Arthrimus/Wii-HDMI/(list of files, drawings)

Other design files:
PCB/Flex QSB/Wii HDMI Board flex 01-30.dip
PCB/Flex QSB/Wii HDMI Board flex.dip
PCB/Main PCB Set/Wii HDMI Board 1.1 Set.dip
