Arthrimus/Wii-HDMI/(threads)

Thread 2 (2020-07-25):

Mousebites missing between IR and HDMI boards?

loopj, 2020-07-25:
Hey @Arthrimus thanks for open sourcing this, this is my favorite board design for GCVideo on Wii!

I've noticed that the Gerbers (on `master` dont show drill holes for the PCB "mouse bites" allowing you to break apart the IR board from the HDMI board. Did you remove the mouse bites or are they accidentally missing from this version?

Thanks again

drandreas, 2020-12-02:
I've re-generated the Gerber files from the `.dip`. That one contains the mouse bites. I've ordered 3 from OSH Park. Looking forward to soldering during the holidays.

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

webhdx, 2021-03-31:
Hey @drandreas Can you open a pull request with updated gerbers or send them to me via e-mail (webhdx@gmail.com)? I can't generate them myself with freeware version of DipTrace. Thanks in advance.

drandreas, 2021-03-31:
https://oshpark.com/shared_projects/WkDGBf2d

drandreas, 2021-03-31:
I’ve also uploaded the flex:
https://oshpark.com/shared_projects/A5FDOKa1

But that one is not tested since I had spare once from Wii-Duals

Thread 3 (2020-12-02):

HDMI modded Wii Mini

webhdx, 2020-12-02:
I thought I would share this. Probably I'm the first person ever to add HDMI to the Wii Mini (I did a lot of research). Wii-HDMI boards fit perfectly to RVO-CPU-01 boards if you remove one filtering cap. HDMI board also need to be dremeled a bit to accommodate 3 caps near the USB port. As you can see it can be soldered using only one row of pins.

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

Thanks for this project. I modded a lot of Wiis using this. It's great that we can make Wii more compatible in the future when Component is finally removed from the TVs.

Arthrimus, 2020-12-02:
Wow, that's awesome. Can you get progressive scan working or does it only
do interlaced?

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

webhdx, 2020-12-02:
It can be done but you need to do Bluebomb hack first. Then you can install original Wii's System Menu which has 480p setting. Also I installed WiFi card which also required new System Menu in order to work.

LakituLakitu, 2025-02-01:
I google wii mini HDMI mod every few months and have done for a long time. You as you know are the only one. I added a gamecube controller port to mine and did Bluebomb years a go and have adored the wii mini ever since. I would love for you to do a detailed wiring map so i could wire this myself. My soldering skills are great if i have some instruction. Long live the wii mini. It's a beautiful thing.

Thread 4 (2021-01-21):

PCB Testing

drandreas, 2021-01-21:
I've noticed that there is no oscillator or other clock source on the PCB. Does the FPGA depend on the 54 MHz-Clock on Pin C or will it run on an internal clock.

I would like to test the Firmware/PCB/HDMI Output before fitting the PCB into the Wii.

drandreas, 2021-01-25:
I've made some progress over the weekend. The FPGA requires an external clock source - a Raspberry Pi (see GPCLK, Pin4) seams sufficient.  Moreover, GCVideo does not output anything as long as it hasn't synced to the Wii's output. I'm currently trying to write test image generator. I will report back when I come up with something useful.

For now, just a warning to all other beginners like me: **TMDS signal pairs are swapped** (this makes for an easier layout without vias).

drandreas, 2021-02-28:
I gave up and just hoped for the best, it worked.

Closed 2021-02-28.

Thread 5 (2021-02-28):

BOM Sugestions

drandreas, 2021-02-28:
I've successfully built 3 PCBs. The IR-Diode is EOL I've ordered all other components from DigiKey.

I suggest the following 2 positions:

The FFC cable is not part of the Excel sheet. Therefore I had to guess the length.
I've ended up with CABLE FFC 20POS 0.50MM 3.94" (100mm), order no 732-5164-ND (687620100002).

I had a hard time hand soldiering the suggested HDMI receptacle. I've then switched to the following alternative:
order no 732-2739-1-ND (685119136923) since it has almost not plastic at the back side there is nothing you could accidentally melt with the soldering iron. Moreover, the exposed part of the pins is significantly longer and hence easier to heat. The alternative part has the same footprint as the original. However, the legs are to long and have to be shortened before soldering to get a flush pcb bottom. They are soft so a side cutter can do the job.

SMazza1, 2021-08-24:
I tried uploading the BOM to Digi-Key and found 5 issues.  Digi-Key was unable to identify the 4 resistors beginning with "0603WAF".  And the IC "TPS74012DGKR" is only available in bulk quantities.

The resistors seem like they should be easy enough to substitute, but Digi-Key's system didn't identify acceptable substitutes for some reason.  I haven't yet tried selecting substitutes from a catalog.

While I haven't studied the circuit very hard, the "TPS74012DGKR" IC seems like it might be a little more sensitive to product substitutions.  Did you find any issue with the substitution for that one?

drandreas, 2021-08-24:
I’ve ordered TPS74012DGKT back in December. I assume the T variant is the successor of the R you mentioned. As far as I know it’s only a 1.8V regular, so not that big of a deal. The boards I assembled have not shown any issues so far.

SMazza1, 2021-08-24:
Thanks, that's helpful.  They have that chip in stock at $4.66 each, no minimum quantity.

For the resistors, it looks like TE products CRGCQ0603F180R, CRGCQ0603F330R, CRGCQ0603F4K7, and CRGCQ0603F10K might work, and are shown in stock at Digi-Key.

drandreas, 2021-08-25:
Sorry, I can’t give any feedback on the resistors. I have an assortment in my shop and usually use what I’ve at hand.

If you are ordering for this specific build - you will meed a .1u 50v cap for the flex. That one is not listed in the BOM as far as I know.

Source: https://forums.black-dog.tech/index.php?threads/wiidual-removed-c43-capacitor-under-flex-cable.37/

jpaglier, 2022-01-19:
I had trouble finding the flash IC - successfully used a MX25V4006EM1I-13G in its place.

Thread 6 (2021-07-09):

Analog video

Bakuku, 2021-07-09:
Is there a way to modify this project to also include the Analog video options that Wii Dual offers?

drandreas, 2021-07-09:
(This is not the answer you were looking for.) Installing Wii-HDMI does not disable the Analog Output. Moreover, I have a Wii with Wii Dual and one with Wii-HDMI and I see no difference between the original analog output and Wii Duals analog out.

Bakuku, 2021-07-09:
But not all of them or al I wrong?

RGBS/RGBHV/RGsB/YPbPr

drandreas, 2021-07-09:
Good Point

Bakuku, 2021-07-09:
What extra components are needed to make that work? It would be great to have a full alternative to WiiDual and that is opensource!

drandreas, 2021-07-09:
If you look at the constraints file of gc-video for the wii-dual: https://github.com/ikorb/gcvideo/blob/main/HDL/gcvideo_dvi/src/constraints-dualwii.ucf you will find the pin-out of the FPGA to the DACs. However, the entire analog pipeline is missing on wii-hdmi. So you need to take those ~24 Signals and build the rest from scratch.

Bakuku, 2021-07-09:
There is some overlap for around ~4-5 pins.
At first glance

Bakuku, 2021-07-09:
P77 = Net DVI_CLOCK[1] (Same on both)
P78 = Net DVI_CLOCK[1] (Same on both)
P88 = NET "DVI_Red[0]"   LOC = P88; / NET "DVI_Green[0]" LOC = P88;
P89= NET "DVI_Red[1]"   LOC = P89; / NET "DVI_Green[1]" LOC = P89
P83 = NET "DVI_Blue[0]"  LOC = P83; (Same on both)
P84 = NET "DVI_Blue[1]"  LOC = P83; (Same on both)
P73 = NET "DAC_Green[0]" LOC = P73 | IOSTANDARD = LVCMOS33; / NET "PadData"      LOC = P73;
P72 = NET "DAC_Green[1]" LOC = P72 | IOSTANDARD = LVCMOS33; / NET "SPDIF_Out"    LOC = P72;
P71 = NET "DAC_Green[2]" LOC = P71 | IOSTANDARD = LVCMOS33; / NET "IRReceiver"   LOC = P71;
P43 = NET "DAC_Green[6]" LOC = P43 | IOSTANDARD = LVCMOS33; / NET "VClockN"      LOC = P43;
P41 = NET "DAC_Green[7]" LOC = P41 | IOSTANDARD = LVCMOS33; / NET "I2S_BClock"   LOC = P41;
P13 = NET "DAC_Blue[7]"  LOC = P13 | IOSTANDARD = LVCMOS33; / NET "VData[5]"     LOC = P13;
P12 = NET "DAC_Clock"    LOC = P12 | IOSTANDARD = LVCMOS33; / NET "VData[4]"     LOC = P12;
P40 = NET "DAC_SyncN"    LOC = P40 | IOSTANDARD = LVCMOS33; / NET "I2S_Data"     LOC = P40;
P3 = NET "CSel"         LOC = P3; / NET "CableDetect"  LOC = P3;
P10 = NET "VData0Old"    LOC = P10 | OFFSET = IN 5 ns VALID 12 ns BEFORE "VClockN" LOW | IOSTANDARD = LVCMOS18 | PULLDOWN = TRUE; / NET "VData[3]"     LOC = P10;
P9 = NET "VData[1]"     LOC = P9; / NET "VData[2]"     LOC = P9;
P7 = NET "VData[2]"     LOC = P7; / NET "VData[1]"     LOC = P7;
P6 = NET "VData[3]"     LOC = P6; / NET "VData[0]"     LOC = P6;
P5 = NET "VData[4]"     LOC = P5; / NET "CSel"         LOC = P5;
P39 = NET "IRReceiver"  LOC = P39; / NET "I2S_LRClock"  LOC = P39;
P94 = NET "I2S_Data"    LOC = P94; / NET "DVI_Red[1]"   LOC = P94;
P93 = NET "I2S_BClock"  LOC = P93; / NET "DVI_Red[0]"   LOC = P93;
P70 = NET "SPDIF_Out"   LOC = P70; / NET "IRButton"     LOC = P70;

Is this what you meant?
I've crosschecked all the pins from the 2 links and these are the ones that overlap.

drandreas, 2021-07-09:
Yes, that's what I meant. Sigh, that's a lot of changes between the 2 layouts...

I'm not sure how familiar you are with FPGAs - I'm sorry if I state obvious stuff blow.

Challenge 1:
In theory almost any FPGA pin can be used for any signal (main exception are clocks, differential pairs and so on). However, all Logical Units (LUTs) are placed within the FPGA by the "compiler". If an input or output pin is far away from the LUT the path length can introduce signal delays and this in turn will reduce the max possible clock rate the FPGA can be run at. Therefore, keeping similar pins next to each other is key. e.g. DVI-Group, VDATA-Group, RGB-Groups (Obviously the "compiler" does optimise the placement to counter this issue but at some point the code will simply not fit into the FPGA and meet the timing requirements).

Challenge 2:
The FPGA usually groups 8-Pins into one Port and some things are defined per Port and not per Pin e.g. the logical voltages (1.8V / 3.3V).

If you are lucky you might be able to just assign the ~27 DAC signals to free pins in constraints-shuriken-v3.ucf and every thing will work. However, based on the challenged listed above I doubt if this is possible. Perhaps a full re-layout is necessary...

I've quickly compared the 2 boards side by side. The layout is defiantly different:
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
So your long list is plausible...

Thread 7 (2021-07-28):

Possible to re-arrance or split gerber for cheaper OSHPark production?

Hojo-Norem, 2021-07-28:
Going by https://docs.oshpark.com/submitting-orders/board-outline/ , OSHPark price PCBs by dimensions rather than surface area.

The design at https://oshpark.com/shared_projects/WkDGBf2d has a lot of open space and wastes a significant amount of money in it's production.

Going by the file extension 'Wii HDMI Board 0.4 Set.dip', I'm guessing you use Diptrace.

I'll give it a go myself if the trial version will let me.

drandreas, 2021-07-29:
Are you considering to move the PCB segment with the HDMI port on it or also additional changes?

Hojo-Norem, 2021-07-29:
Just move the HDMI section, unless you had some ideas.  Anyway, I got Diptrace installed and when I loaded 'Wii HDMI Board 0.4 Set.dip' I got the following dialogue:
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
This is my first time using Diptrace (I dabble a little with Eagle) so I just answered yes.
After a bit of messing around I managed to make this, using OSHPark's cutout guidelines:
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
[Wii HDMI Board 0.4 Set rearranged.zip](https://github.com/Arthrimus/Wii-HDMI/files/6903720/Wii.HDMI.Board.0.4.Set.rearranged.zip)

I generated the gerbers and uploaded them to OSHPark, where the quoted price is $23.10, vs $34.60 for the original.

Also, just to see what the difference was, I cut the PCB into it's three sections and uploaded the.  The total quoted price was $21.50.  I took the re-arranged PCB and removed the IR section and the total cost for the combined FPGA+HDMI sections and perseverate IR section comes to $19.65.

drandreas, 2021-07-30:
As you may have noticed, I'm not the original author. I just had some PCBs produced and successfully installed. If you would have separated the IR-Part I would have argued against it. On my first install I separated the 2 parts and realized then, that the install would have been significantly easier if I had kept them connected. The entire PCB with the HDMI part removed fits perfectly into the Wii.

I recall getting the same error message, but I can't remember how I answered the Question - sorry. I suggest you double check the gerbers. As long Dip does not add connections between traces that were not connected in the original you will be fine.

One side note my first batch produced was 1.6mm thick the Metal - ESD Cover of the Wii did not fit into the hole. I did the second PCB batch with 0.8mm thickness that one warped a little and the castellations ware partly damaged but recoverable. On the plus side I was able to fit the ESD Cover.

Thread 8 (2021-08-17):

Losing Composite Video when installing Wii-HDMI

Orcut, 2021-08-17:
When I install Wii-HDMI 0.4, I am losing composite video.  I know in the main description it says the Wii-HDMI is similar to Wii Dual, but that it only does HDMI.  So I was thinking that it just doesn't support the component features that the Wii Dual has.  Does anyone know if losing composite is a normal thing that happens?  If so, is there a way to get it working again?

drandreas, 2021-08-18:
I don't have any devices with analog input at hand. However if you set "Allow 480p mode" to off than composite should work like no Wii-HDMI was installed:
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

In all cases component should work like before the install.

Orcut, 2021-08-18:
Thank you for your input.  I just tried turning off "Allow 480p mode" and it did not work unfortunately.  If component should work like before the install as you said, then shouldn't composite work as well?

drandreas, 2021-08-18:
Strange, very Strange.

I don't have any analog input devices anymore. However I've tried to send the signal trough a Wii2Hdmi and use the WiiHDMI simultaneously and it works like a charm:

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

drandreas, 2021-08-29:
I've checked the v0.4 PCB. Pin 8 is tied to 3.3V (Pin 10). The Wii will therefore always assume that the console is connected to a TV using a component cable. I’m sorry for suggesting `Allow 480p mode`. I now know, that it has not effect when used on a v0.4 PCB of this repo. You can try to break the trace with an exacto knife to enable composite:

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

Thread 9 (2021-09-03):

Clarification Regarding v0.3 and v0.4

ianmarmour, 2021-09-03:
I'm not sure if anybody has context on this but I'm going to start attempting to build one of these soon and I noticed in this post,

https://github.com/Arthrimus/Wii-HDMI/issues/2

That there is a v0.4 board that was posted by drandreas however on Arthrimus's OshPark there's only a v0.3 board which one should I order and are there any differences between the two? I know Arthrimus is on a break right now but maybe someone else will know.

drandreas, 2021-09-03:
You should ask @Hojo-Norem if he had success with his re-aranged board presented in #7. I liked that Idea.

Hojo-Norem, 2021-09-03:
The PCBs arrived about week ago, but I haven't had chance to get the parts ordered yet.  They looked like they came out okay, and the HDMI section separated from the FPGA section without issue.  That being said, I misjudged the scale of everything, meaning that I had to take care when snapping the two PCBs apart as there is a trace running rather close to the snap line on the FPGA pcb.

Thread 11 (2023-05-31):

Several questions around the project

mattie47, 2023-05-31:
I've been reading through this project, and trying to narrow down how easy it would be to get manufactured, flash it, and finally install.

I see there's a few useful resources around such as:
- https://www.youtube.com/watch?v=8VhgLiL9o7c
- https://www.youtube.com/watch?v=odxJZlh90ks

**Questions:**
1. Is there a schematic for this anywhere?

I see the Diptrace dip file (and have downloaded and tried out diptrace as a result) but I see it's just the board.

2. I understand the repo's gerber files are actually out of date? i.e. 0.3 (without mouse-bites), and not 0.4

I see @drandreas has uploaded this variant of gerber to oshpark here: https://oshpark.com/shared_projects/WkDGBf2d

Any reason no one in the issues section here hasn't submitted a PR to the project with newer gerbers? It's better practise than going off-site.

3. Has anyone tried getting the boards with smt assembly?

Given there's not a schematic file to go along with the board file, it's not exactly easy to generate a pick and place file.

I was planning on trying to get a couple of these manufactured with smt assembly at jlcpcb.

4. Has anyone got any installation pics of this project?

Whilst there are some install photos on https://arthrimus.com/wii-hdmi-mod/, ~I've been trying to understand the usage of the flex cable i.e. https://github.com/Arthrimus/Wii-HDMI/tree/master/PCB/Flex%20QSB~

~Perhaps I missed it in some of the videos, and other comments/posts around, but I haven't come across an install with pics that's actually using it.~

~The main post of this project here https://arthrimus.com/wii-hdmi-mod/ states _"this mod is HDMI only, and does not have a custom flex cable designed for connecting it to the AVE-RVL chip"_. Am I mis-interpreting, or is this statement no longer true?~

Screenshot below from https://youtu.be/odxJZlh90ks?t=1068 showing the flex install:

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

-------

In terms of flashing the board, I see again @drandreas has written up some brief useful instructions [here](https://github.com/ikorb/gcvideo/issues/65#issuecomment-835420544) (thanks):

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

In other news, it looks like there's another variant/board out for 2023 although sadly doesn't look opensource - AVE-HDMI Kit https://www.youtube.com/watch?v=v44PfH3R4iA / https://electron-shepherd.com/products/ave-hdmi-kit

As for another project, I'm not sure whether https://github.com/wmi-0/wiihdmi also was production worthy...

Thanks,

Matt

drandreas, 2023-06-21:
I haven't found any schema myself. So I took the gamble with the PCBs you found on oshpark. I haven't had any issues with my installs so far. Yes, creating a pull request would have been nice. But since most of my discussions i.e. #5 went nowhere I didn't bother investing time into it. If you are interested in the pinout please see the FPGA definition file: https://github.com/ikorb/gcvideo/blob/main/HDL/gcvideo_dvi/src/constraints-shuriken-v3.ucf

I haven’t tried any other PCBs so I can’t comment on if they are better or worse.

Thread 12 (2023-12-26):

Alternative Flex QSP

mattie47, 2023-12-26:
Hi all,

Just curious if anyone sees issues as-is with modifying the flex cable based on below requirements?

Basically I've decided to build one of these and found the flex cable holes are too small for jlcpcb manufacturing:

> As shown below, for those 0.25mm holes as the board edge.
>
>Could you please kindly enlarge them to minimum size 0.3mm and keep minimum space between hole edge to hole edge to be at least 0.3mm?

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

In the off chance that someone has already run into the same issue, and has modified the flex cable already, that would also be useful!

Thanks

Arthrimus, 2023-12-27:
Interesting, JLCPCB recently made a batch of these for me and they also had an issue with the hole spacing, however they were able to shrink the holes for the castellations down to .015mm which solved the spacing issue and the flex cables turned out fine. I would ask them if they can do that for your order. To increase the hole size and the hole spacing would be impossible because it would no longer match the pitch of the AVE-RVL chip.

mattie47, 2023-12-27:
Hey thanks for responding @Arthrimus.

You couldn't possibly attach the updated gerbers from that order to the thread?

I just find things can sometimes get lost in translation with jlc. All good if not :-)

Arthrimus, 2023-12-27:
I just pushed the most current PCB and Flex revisions to the repository. The PCB is on V1.1 now and the flex is on V2.

mattie47, 2023-12-28:
Thank you!

I have submitted the new gerbers for both pcb and flex cable, and after a bit of back&forth with JLC, they are in production.

I've ordered all components except the fpga and voltage regulator from lcsc. I ended up getting those from Aliexpress as I couldn't find an alternative regulator from lcsc, and the fpga is quite hard to find.

Looking forward to building once everything arrives!

Thank you!

Arthrimus, 2023-12-28:
Best of luck. The FPGAs have always been the biggest hangup on this project. Aliexpress can definitely be hit and miss when buying FPGAs, I've received a lot of good working parts, but I've also been scammed. I hope it works out well for you.

mattie47, 2024-01-05:
Worth highlighting you also did a stream of the latest board installs!

https://www.youtube.com/watch?v=xUvR5mSGkro&t=306s

I expect to wait another week or so for my boards.

I couldn't help but notice on https://retro-system.com/shuriken%20video.htm that the creator of that board (gamecube) used the xc3S50a FPGA as an alternative to the xc3S200a. I'm curious if that option ever crossed your mind, given there's a variant in stock on LCSC [C442405](https://www.lcsc.com/product-detail/Programmable-Logic-Device-CPLDs-FPGAs_XILINX-XC3S50AN-4TQG144I_C442405.html). I realize what you've made is a few years old now, and likely the XCS3S200a wasn't as hard to get pre-chip shortage. FPGAs are completely new territory for me, and I haven't done a datasheet comparison between the two regardless...

**Couple quick other questions:**

>Wii Dual, which was another GCVideo project for the Wii designed by Dan Kunz(citrus3000psi) which had dual output capability providing HDMI and analog output options.

I'm assuming you're referring to the RBG output the wii dual provided?

In the case of the Wii-HDMI, I assume the original component/composite out will still work in conjunction with the HDMI?

**BOM**

I think you've also updated the BOM which is great.

I had gone through previously and tried to find alternative components, and see I picked a number of the same LCSC components.

**I thought it would be useful to list the alternatives to the [BOM](https://github.com/Arthrimus/Wii-HDMI/blob/master/PCB/Main%20PCB%20Set/Wii%20HDMI%20Main%20PCB%20Set%20BOM.csv) below, especially as a couple original LCSC items are out of stock**

| Designator | MPN               | QTY | DESCRIPTION                  | VALUE        | Footprint            | Orignal LCSC Part # | LCSC or Alt Part #                                      |
|------------|-------------------|-----|------------------------------|--------------|----------------------|---------------------|---------------------------------------------------------|
| D1,D2,D3   | SP3012-04UTG      | 3   | TVS DIODE                    | 5V 7V        | uDFN-10_1.0x2.5x0.5P | C2847056            | C151304                                                 |
| U1         | XC3S200A-4VQG100C | 1   | IC FPGA                      | 68 I/O       | 100VQFP              | C1521645            | https://www.aliexpress.com/item/1005005994068931.html   |
| U3         | TPS74012DGKR      | 1   | IC REG LINEAR                | 1.2V 1.5A    | 8MSOP                | C2871413            | https://www.aliexpress.com/item/1005005244642111.html   |
| U4         | M25P40-VMN6PB     | 1   | IC FLASH                     | 4M SPI 75MHZ | 8SOP                 | C2928800            | C152601 (Possibly also C19551125 but that's 100MHZ) OR https://www.aliexpress.com/item/1005005450756300.html  |
| U5         | 2001-1-2-21-00-BK | 1   | CONN RCPT MINI   HDMI 19POS  |              | SMD RA               | C720618             | C2962408                                                |
| SW2        | EVQ9P701P         | 1   |                              |              |                      | C79158              | C2828254                                                |
| CONN1,2    | 2-1734592-0       | 2   |                              |              |                      | C573703             | C262565                                                 |

mattie47, 2024-01-12:
Would it also be possible to get the STL/STEP file you've used for the 3D print to assist with case HDMI cutout? Much appreciated!

clegg89, 2025-09-02:
I put in an order to JLCPCB recently for the 01-30 flex and they rejected saying the whole size was too small:

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

I guess this means they can't/won't manufacture the flex anymore?

Thread 13 (2024-02-25):

Flashing image questions

mattie47, 2024-02-25:
Finally had a weekend to build and assemble this project, and about to install into Wii.

Just wanted to check a couple things with others to confirm I've flashed the chip correctly.

On https://github.com/Arthrimus/Wii-HDMI/issues/5 @jpaglier stated an alternative flash chip could be used. In this case, the [MX25V4006EM1I-13G](https://www.lcsc.com/product-detail/NOR-FLASH_MXIC-Macronix-MX25V4006EM1I-13G_C152601.html). I have gone ahead and used this as opposed to the original project chip.

I then downloaded the latest release [gcvideo-3.1-shuriken-v3-wii.zip](https://github.com/ikorb/gcvideo/releases/download/GCVideo-DVI_release_3.1/gcvideo-3.1-shuriken-v3-wii.zip) and attempted to flash using flashrom on a Raspberry Pi.

```
pi@octopi:~ $ flashrom -p linux_spi:dev=/dev/spidev0.0,spispeed=256 -w  gcvideo-dvi-shuriken-v3-wii-3.1-spirom-complete.bin
flashrom  on Linux 5.10.103-v7+ (armv7l)
flashrom is free software, get the source code at https://flashrom.org

Using clock_gettime for delay loops (clk_id: 1, resolution: 1ns).
Found Macronix flash chip "MX25L4005(A/C)/MX25L4006E" (512 kB, SPI) on linux_spi.
Error: Image size (346144 B) doesn't match the flash chip's size (524288 B)!
 ```

**As above, this complained about the image size.** To get around this, I needed to pad the file out to the flash chip size.

I understand I could do this using 0xff or possibly 0x00 bytes added to the end of the bin file, however I've read some people having issues doing so (not with Wii/gamecube wiiHDMI but unrelated projects).

It seems to be best to pad out the chip with the rom image again filling to the total bytes.

From this reddit thread:
https://www.reddit.com/r/techsupport/comments/dc8jmw/flashed_a_2mb_bios_rom_on_a_16mb_chip_cant_get_it/

We should be able to use the DD command. First we make a copy of our bin file which will be our target file for appending to.

`cp gcvideo-dvi-shuriken-v3-wii-3.1-spirom-complete.bin gcvideo-dvi-shuriken-v3-wii-3.1-spirom-complete-copy.bin`

Next we pad out the copy file using dd. We do this to a total size of 524288 bytes (512kb) minus 346144 bytes (gcvideo bin size) = 178144 bytes.

```
dd if=gcvideo-dvi-shuriken-v3-wii-3.1-spirom-complete.bin of=gcvideo-dvi-shuriken-v3-wii-3.1-spirom-complete-copy.bin bs=2097152 oflag=append count=1 conv=notrunc
```
Now we have a bin file we can burn to our flash chip:

```
flashrom -p linux_spi:dev=/dev/spidev0.0,spispeed=256 -w gcvideo-dvi-shuriken-v3-wii-3.1-spirom-complete-copy.bin
flashrom  on Linux 5.10.103-v7+ (armv7l)
flashrom is free software, get the source code at https://flashrom.org

Using clock_gettime for delay loops (clk_id: 1, resolution: 1ns).
Found Macronix flash chip "MX25L4005(A/C)/MX25L4006E" (512 kB, SPI) on linux_spi.
Reading old flash chip contents... done.
Erasing and writing flash chip... Erase/write done.
Verifying flash... VERIFIED.
```

**Should this work? and was this the correct way I should have burned the flash chip?**

_**Further notes for others attempting to flash via RPI**_

Wiring up:

_Note: If you're familiar with SPI bus, sometimes it's not always clear if you need to cross over MOSI and MISO in wiring up. In the case of Wii-HDMI, this isn't required. Simply connect the Pi's MISO to the silkscreen labelled MISO, followed by MOSI to MOSI._

Next, make sure SPI is enabled in `boot/config.txt`:
```
# Uncomment some or all of these to enable the optional hardware interfaces
#dtparam=i2c_arm=on
#dtparam=i2s=on
dtparam=spi=on
```

Note: Initially I had only tried following https://github.com/ikorb/gcvideo/issues/65#issuecomment-835420544 instructions by @drandreas however I could not get things working using the `dtoverlay=jedec-spi-nor,flash-spi0-0` overlay. Simply enabling spi above was enough for flashrom to work for me.

Thanks,

Matt

Arthrimus, 2024-02-25:
I've used larger flash before and padded the end of the file with the hex value FF. This has worked without issue. I do all of my programming on a Windows system so I use a GUI flashing utility that handles the padding automatically so I haven't really looked into this further than that.

Thread 14 (2024-03-02):

0.4 vs 1.1 - Swapping of R4 and C3

mattie47, 2024-03-02:
Just curious, but is there a reason why C3 and R4 were swapped around between revisions?

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

You may also wish to fix the silkscreen for R4 in 1.1

Thanks

Thread 15 (2024-09-05):

Wii-HDMI working fine except on Sony TV

philenotfound, 2024-09-05:
Hi, I have successfully installed Wii-HDMI on my RVL-CPU-20.
It works fine on my test monitor.

When I connect it to a Sony KDL-48W705C it recognizes that the input is active but only shows a black screen.

Same cable works fine on an 24" Acer TV/Monitor.
I also tried running it through an Onkyo AV-Receiver, where the HDMI logo on the receivers small display just keeps turning on and off.
I also did not have luck running it through an active HDMI switch. The switch never recognizes a signal.
I also tried various other, shorter HDMI cables, still no luck.

Wii-HDMI is outputting 480p which should be supported by any HDMI display.
Am I missing something obvious?

Arthrimus, 2024-09-06:
Have you tried it with the Enhanced DVI setting turned off? Some TVs don't like the way GCVideo produces the enhanced DVI signal and won't recognize it. Unfortunately enhanced DVI is required for digital audio, so if your TV won't accept it then you'll need to find a way to connect analog audio to your TV from the Wii's AV port.

philenotfound, 2024-09-06:
Yes, I have tried that. Still only a black picture..

Arthrimus, 2024-09-06:
Did you build the WiiHDMI board yourself or did you buy it preassembled from somewhere?

philenotfound, 2024-09-21:
I bought it preassembled.

johnblade, 2025-09-27:
Hello, did you find a workaround about this ?
I have a LG G3 with a RT4k and a HDMI switch.
HDMI switch works pretty well even with a MiSter and DVI.
But when I plug the wii-hdmi on this switch, it doesn't recognize signal, if I plug the wii-hdmi directly into the rt4k it works well.
Tried two different cables and also with a HDMI cable and a dongle.
Do you have maybe some recommendation about a compatible switch or splitter ?

philenotfound, 2025-09-27:
Unfortunately not.

Thread 16 (2025-04-01):

Question about the board thickness.

Extremious, 2025-04-01:
Hello, what should be the thickness of the main PCB?

drandreas, 2025-04-05:
I've had good results with 0.8mm

mattie47, 2025-04-09:
@Extremious, as highlighted by @drandreas, 0.8mm works well. This is also mentioned on the OSHPARK shared project:

https://oshpark.com/shared_projects/WkDGBf2d
