Arthrimus/Wii-HDMI/(commit log)

2023-12-27 Updated All Board Files to V1.0
    Updated main PCB dip file and Gerbers to V1.0 Version
    Updated Flex PCB to V2.
    [BoardOutline.gbr, Bottom.gbl, BottomMask.gbs, BottomPaste.gbp, BottomSilk.gbo, Through.drl, Top.gtl, TopMask.gts]
2023-12-27 Fix Error with board revision
    Updated board file and Gerbers to V1.1
    [Wii HDMI Board 1.0 Set.dip, Wii HDMI Board 1.1 Set.dip]
2024-08-26 Fix issue with JP1 shorting to ground
    [Wii HDMI Board 1.1 Set.dip, Wii HDMI Board flex 01-30.dip, Wii HDMI Board flex.dip]
